no5tyle/pinewood-time/hardware/gate/stl/led_lens.stl

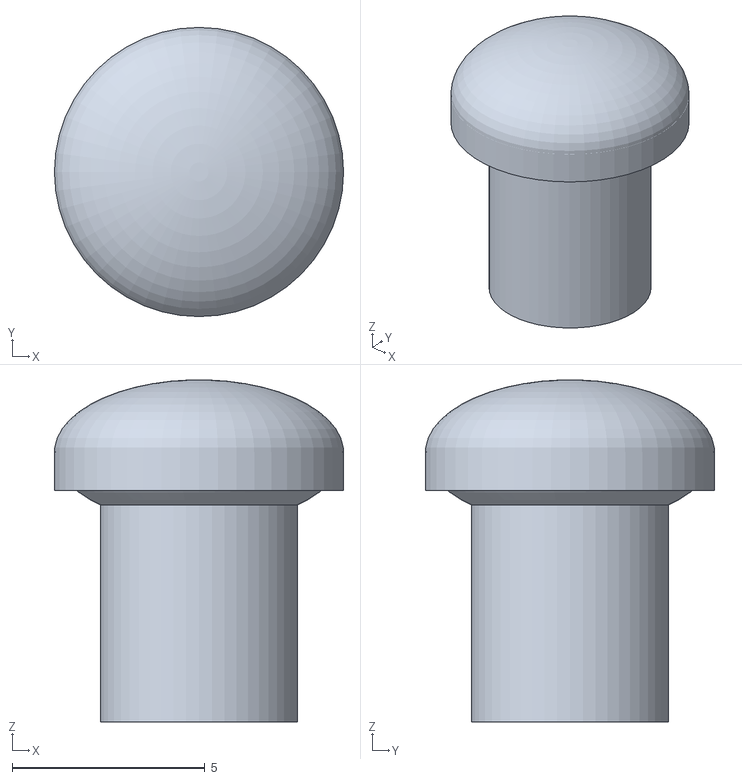
[picture p7: CAD file, 2026-11-12]
hardware/gate/stl/led_lens.stl
7.50 x 7.50 x 8.87
