no5tyle/pinewood-time/hardware/gate/stl/cover.stl

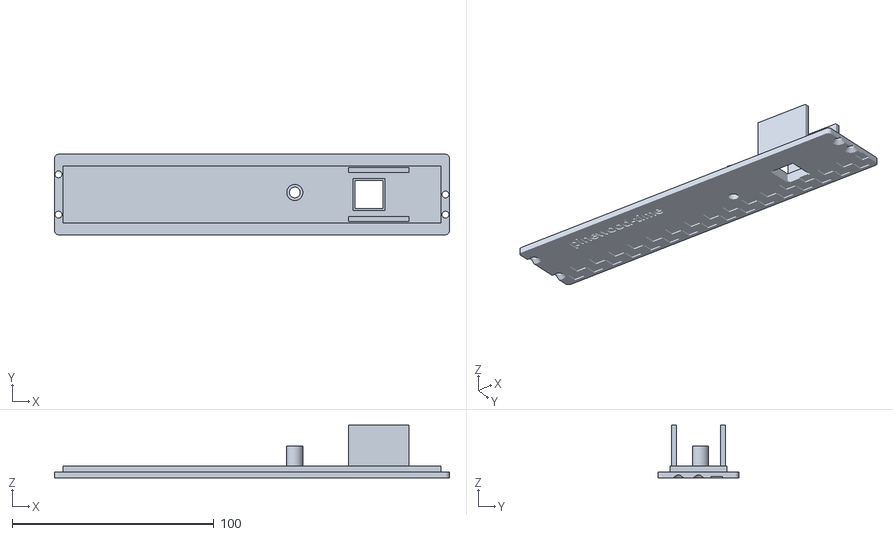
[picture p8: CAD file, 2026-11-12]
hardware/gate/stl/cover.stl
196.0 x 40.0 x 26.2
