no5tyle/pinewood-time/hardware/gate/stl/sensor_bar.stl

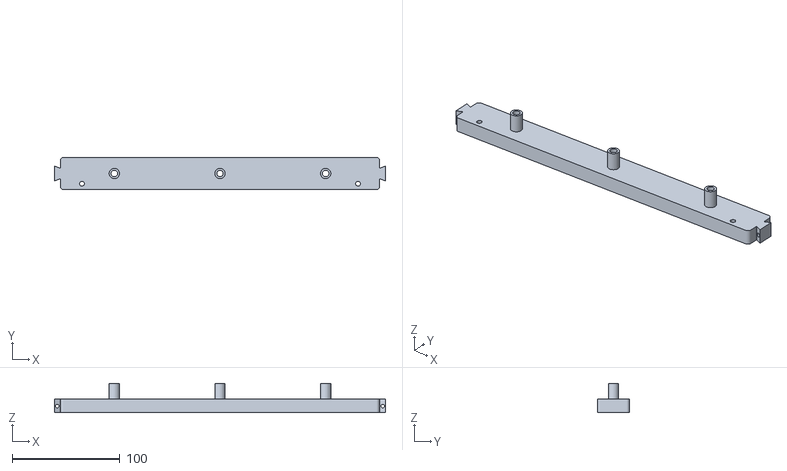
[picture p9: CAD file, 2026-11-12]
hardware/gate/stl/sensor_bar.stl
307.0 x 30.0 x 27.0
