no5tyle/pinewood-time/hardware/gate/stl/mx_blank.stl

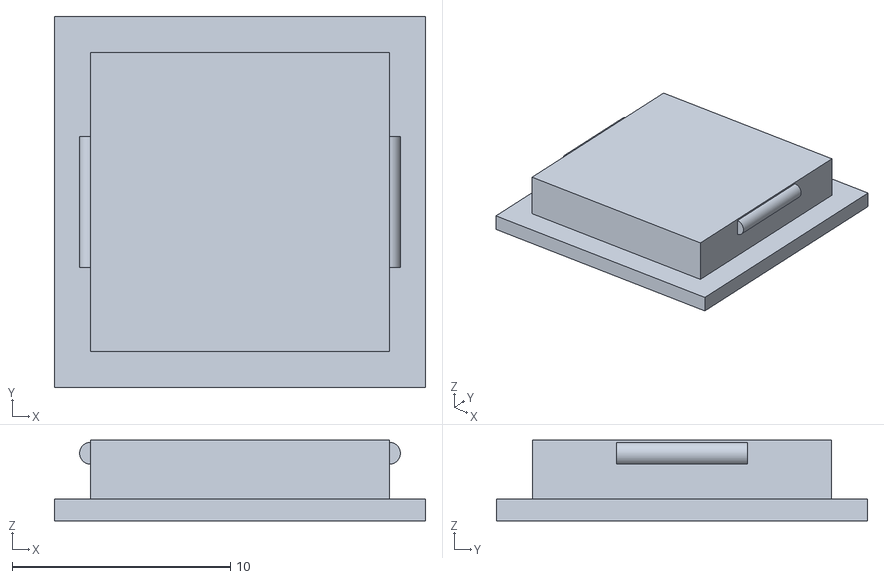
[picture p10: CAD file, 2026-11-12]
hardware/gate/stl/mx_blank.stl
17.0 x 17.0 x 3.70
