no5tyle/pinewood-time/hardware/gate/stl/right.stl

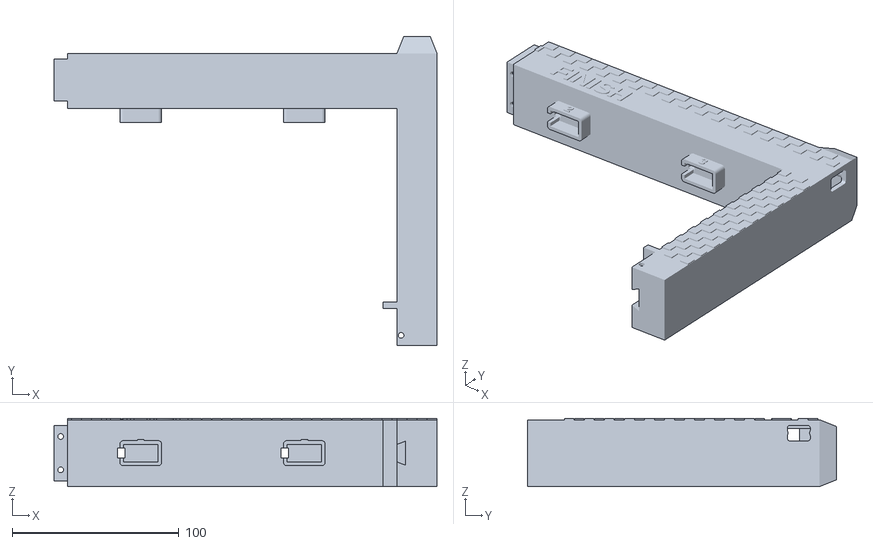
[picture p11: CAD file, 2026-11-12]
hardware/gate/stl/right.stl
229.5 x 185.0 x 40.8
