no5tyle/pinewood-time/hardware/gate/stl/left.stl

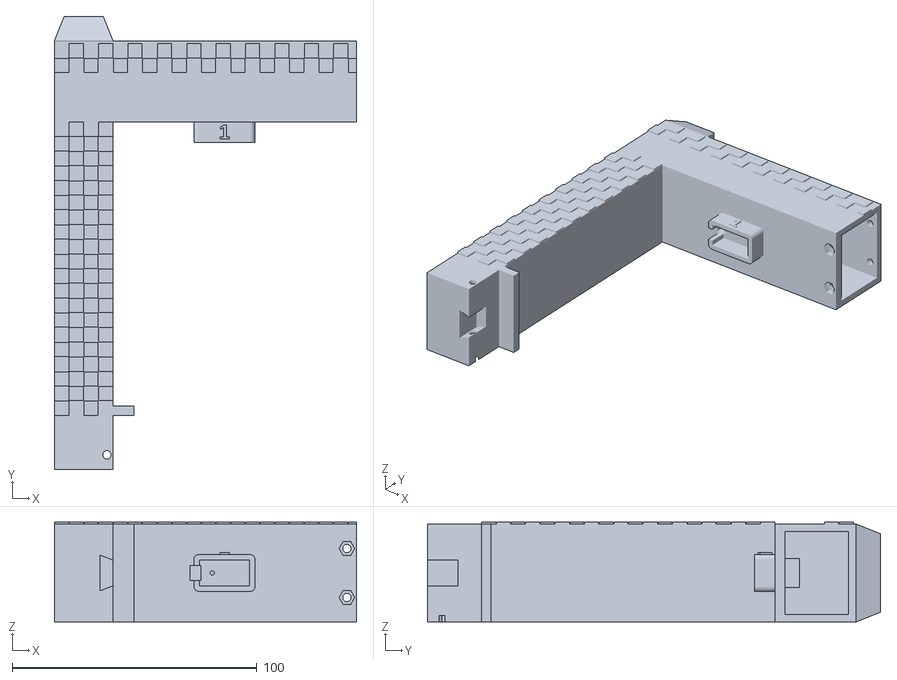
[picture p12: CAD file, 2026-11-12]
hardware/gate/stl/left.stl
123.5 x 185.0 x 40.8
