no5tyle/pinewood-time/docs/build-guide.pdf

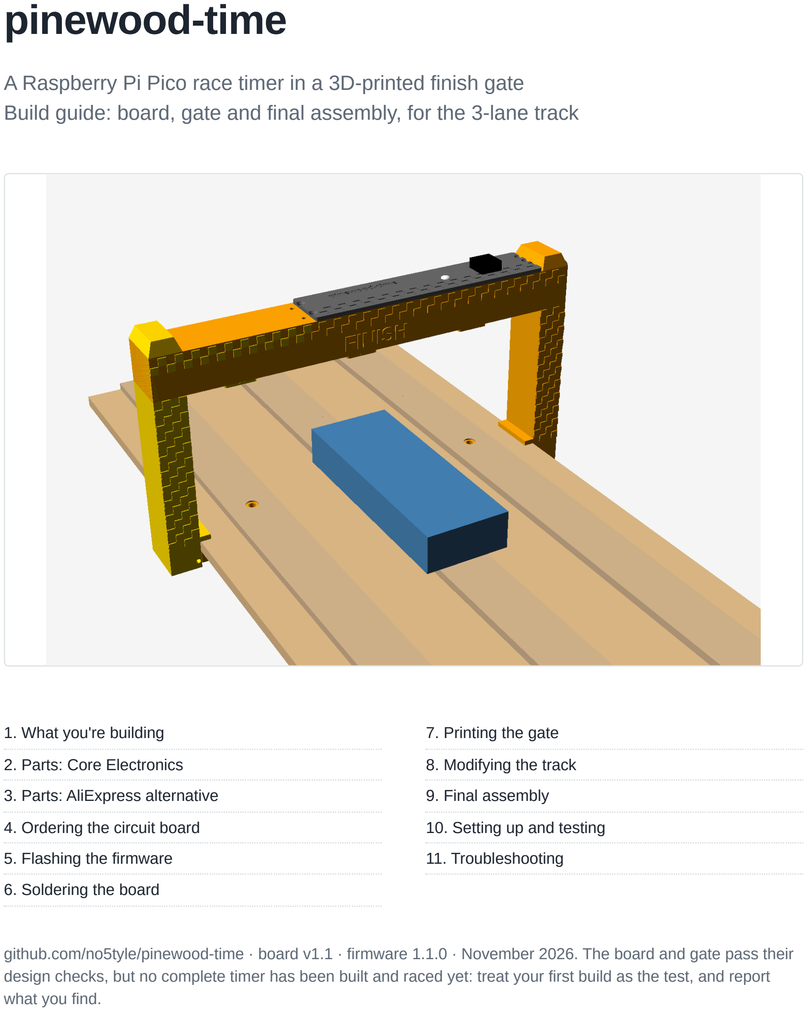
[picture p14: figure]
pinewood-time; 1. What you're building; 2. Parts: Core Electronics; 3. Parts: AliExpress alternative; 4. Ordering the circuit board; 5. Flashing the firmware; 6. Soldering the board; 7. Printing the gate; 8. Modifying the track; 9. Final assembly; 10. Setting up and testing; 11. Troubleshooting; what you find.

## A Raspberry Pi Pico race timer in a 3D-printed finish gate Build guide: board, gate and final assembly, for the 3-lane track

github.com/no5tyle/pinewood-time · board v1.1 · firmware 1.1.0 · November 2026. The board and gate pass their design checks, but no complete timer has been built and raced yet: treat your first build as the test, and report

pinewood-time build guide | 1 / 13

## 1. What you're building

A finish-line gantry that clamps onto the end of the track. A break-beam sensor watches each lane: an infrared emitter set into the rail shines up to a receiver in the gantry above, and a car crossing the line breaks the beam. The timer board inside the gantry's beam stamps each lane's crossing with the Pico's microsecond clock, counted from the moment the start gate drops, and sends the results to the race software over USB.

Timing: up to 8 lanes (this guide fits 3), results to 0.0001 s.
Race software: speaks the PDT timer's serial protocol, so software with a PDT option should drive it. Button: an MX keyboard switch on top resets the timer, or (with #button next ) calls up the next heat. Status light: amber blinking = waiting, green = ready, blue = racing, red = finished, white = test mode. Connection: one USB-C socket on the side of the gate; it's powered from the laptop.

The timer board, 178 × 28 mm. Lanes 1–8 on the left, then the gate, reset, display and spare connectors, the status light, and the Pico at the right-hand end.

Lane sensor input (x8, lane n 1..8
Jn: JST XH 4-pin, lane n to GP(n-1)

1 LED

2 SIG

3 GND

4 5V

Jn | Rn 180

5V

R10+n) 10k

3V3

R20+n) 1k
GP(n-1)

5V

A break-beam receiver or phototransistor switches SIG to GND as a car passes.

Start gate and reset
Switches to GND

1

2

J9 GATE

R31 10k

3V3

R32 1k
GP18

1

2

J10 RESET | R33 10k

3V3

R34 1k
GP19

Status light
D1 5 mm RGB, common cathode

GP20

R37 220

R

GP21

R38 220

G

GP22

R39 220

B

amber: waiting · green: ready · blue: racing · red: done

Lane displays I2C
J11 GND 3V3 SCL SDA
GP17 | SCL

R35 4.7k

3V3

GP16 | SDA

R36 4.7k

3V3
HT16K33 backpacks, address 0x70 lane 1

Power (from the Pico's USB
VBUS (pin 40 5V rail; 3V3 OUT (pin 36 3V3 rail

VBUS

5V rail

C1 100µF

3V3 OUT

3V3 rail

C2 100nF

J12 AUX GND, 3V3, 5V, GP26, GP27, GP28 for extras.

The circuit. Every input is pulled up to 3.3 V and reaches the Pico through a 1k resistor, so anything that switches to ground works.

### Tools

Soldering iron (a fine conical or 2 mm chisel tip), solder, side cutters
JST XH crimp tool (or solder the wires to pre-crimped leads), wire strippers
3D printer with a bed of at least 256 × 256 mm (the sensor bar lies diagonally)
Drill with a 10 mm bit and a small pilot bit, screwdrivers, M3 and M4 hex keys or spanners A computer with a serial terminal (the Arduino IDE's serial monitor, PuTTY, or screen )

## 2. Parts: Core Electronics

Everything for one 3-lane timer except the boards (JLCPCB, section 4) and the fasteners. Prices are rough, in Australian dollars with GST, from November 2026; check the listings before ordering.

Qty | Item | For | About
1 | Raspberry Pi Pico (or Pico H; solder it flat or on 2.5 mm headers) | U1 | $8–10
3 | Adafruit IR break-beam sensor, 3 mm LEDs (ADA2167) | one pair per lane | $6.20 each
1 | SparkFun resistor kit, 1/4 W, 500 pcs (COM-10969) | 5 × 10k, 5 × 1k, 3 × 220 Ω | $15
1 | DFRobot JST connector kit (FIT0255) | lane, gate and reset sockets, plugs, crimps | $14
1 | 100 µF radial electrolytic, 6.3 mm, 2.5 mm leg spacing (CE05258) | C1 | $1
1 | 100 nF ceramic disc, 5 mm leg spacing (CE05188) | C2 | $0.40
1 | SparkFun RGB LED, 5 mm, common cathode (COM- 09264) | D1, status light | $3.85
1 | 2.54 mm male header strip | J12 (1 × 6), and J11 if you fit displays | $1
1 | MX keyboard switch and a 1u keycap (any) | the button | $3
1 | Adafruit panel-mount USB-C to Micro-B cable, 30 cm (ADA4056) | USB-C socket on the gate | $10.60
1 | Lever microswitch | start gate | $2
1 | USB-C data cable (not charge-only) | gate to laptop | $8
~12 m 2-core cable (alarm or speaker wire) | start gate switch, about 10 m | $6

About A$100 for the parts, plus the boards and fasteners. The resistor and connector kits leave plenty for more boards.

### Fasteners (any hardware store, or an assortment kit)

Qty | Item | For
2 | M3 × 35 bolts and nuts | joining the two gate halves
2 | M3 × 40 bolts and nuts | lock pins through the legs and the sensor bar
4 | M3 × 12 countersunk self-tapping screws | the top cover
2 | M4 × 16 bolts and nuts | thumbscrews that clamp the gate to the track
2 | M2.5 × 6 self-tapping screws | the board's left end
6 | M2 × 10 self-tapping screws | one through each sensor's mounting hole

Not needed for 3 lanes: the 180 Ω resistors (R1–R8) only power bare IR LEDs, and the 4.7k resistors (R35, R36) and J11 are only for lane displays. The full 8-lane parts list is in hardware/fab/bom.md .

## 3. Parts: AliExpress alternative

Cheaper, slower (2–4 weeks), and you choose the seller, so check each listing's photos and dimensions. These are search terms rather than links, because listings come and go. The prices are typical figures for small packs, not quotes. Check them on the day.

Qty | Search for | Check | Typical
1 | "Raspberry Pi Pico RP2040" (official, from a store selling genuine boards) | Pico, or Pico 2 for the RP2350 build. Clones work if they're pin- compatible, but buy one marked Raspberry Pi if you can. | A$6–9
1 | "1/4W metal film resistor kit 600pcs" | Includes 10k, 1k, 220 Ω (and 4.7k). | A$3–5
1 | "XH2.54 connector kit 2P 3P 4P" with straight pin headers | Must say XH. KF2510 kits look alike but don't fit XH sockets. | A$4–7
1 | "electrolytic capacitor 100uF 16V 6.3x11" (or an assortment) | 6.3 mm diameter, 2.5 mm leg spacing. | A$2
1 | "ceramic capacitor 104 100nF 50V" (5 mm leg spacing) | Disc or multilayer, 5 mm pitch. | A$1–2
1 | "5mm RGB LED common cathode 4 pin" | Common cathode, legs in the order R, K, G, B (K the longest). | A$1–2
1 | "2.54mm single row male pin header 40P" | | A$1
1 | "MX switch" (Gateron, Outemu, Kailh) and "1u keycap" | 3-pin or 5-pin MX switch; plate-mount clips are what hold it in the cover. | A$3–6
1 | "panel mount USB type C female to micro USB male screw" | Must match the Adafruit one: 28 × 8.5 mm flange, M3 screws 20 mm apart, body 13 mm thick, about 40 mm long. Or adjust usb_cut in the model. | A$3–6
1 | "micro switch lever KW11" (or
similar)
Normally-closed contact (C and NC terminals). | A$1–2
1 | "M2 M3 M4 screw nut assortment
kit" (and M2.5 self-tappers)
See the fastener table on the previous page. | A$6–
10

Buy the sensors from Core Electronics (or Adafruit). The gate's pockets fit the Adafruit sensor's Omron housing exactly: 20 × 10 × 8 mm, LED on the broad face 5 mm from one end, 2.4 mm mounting hole 10 mm from the LED. Generic "IR break beam" pairs on AliExpress come in many housings and outputs. If you do buy them there, check the housing against those numbers, and that the receiver has an open-collector (NPN) output that goes low while it sees the beam.

A mixed order (sensors from Core, the rest from AliExpress) comes to roughly A$50–60 plus the boards.

## 4. Ordering the circuit board

The board is ordered as Gerber files: one zip, hardware/fab/pinewood-time-gerbers.zip , from the repository. JLCPCB is described here; PCBWay and others take the same zip.

1. Go to jlcpcb.com and choose Order now, then Add gerber file, and upload the zip. It reads the size itself: it should show 178 × 28 mm, 2 layers.
2. Settings: base material FR-4, 2 layers, quantity 5 (the minimum), thickness 1.6 mm, any colour, surface finish HASL (with lead or lead-free). Leave everything else at the default.
3. Check the preview: lane numbers 1–8 along one side, the Pico's outline at the right-hand end, and "pinewood-time v1.1" on the back.
4. Don't add assembly (it's all through-hole and quick to solder). Choose shipping and order.

Expect about US$5–10 for five boards plus shipping, arriving in one to two weeks.

The back of the board.

## 5. Flashing the firmware

Do this before soldering the Pico in, so you know it works.

1. Download dist/pinewood-time-pico.uf2 from the repository (or pinewood-time-pico2.uf2 for a Pico 2).
2. Hold the Pico's BOOTSEL button while plugging it into the computer. It appears as a drive called RPI-RP2 (RP2350 for a Pico 2).
3. Copy the .uf2 file onto it. The drive disappears and the Pico restarts as the timer.
4. Open the new serial port in a terminal (COMn on Windows, /dev/ttyACM0 on Linux, /dev/cu.usbmodem… on a Mac; any baud rate). Send I : it replies with its version and settings.

To update it later, either repeat this, or open the port at 1200 baud, which restarts the Pico ready for new firmware.

## 6. Soldering the board

For 3 lanes, fit these and leave the rest empty. Empty places do no harm, and can be filled later for more lanes.

Fit | Value
R11, R12, R13 | 10k (lane pull-ups)
R21, R22, R23 | 1k (lane series)
R31, R33 | 10k (gate, reset)
R32, R34 | 1k (gate, reset)
R37, R38, R39 | 220 Ω (status light)
C1, C2 | 100 µF, 100 nF
D1 | RGB LED
J1, J2, J3 | 4-pin JST XH (lanes 1–3)
J9, J10 | 2-pin JST XH (gate, reset)
J12 | 1 × 6 header (emitter power)
U1 | Pico
Leave empty | Why
R1–R8 | only for bare IR LEDs
R14–R18, R24–R28, J4–J8 | lanes 4–8
R35, R36, J11 | lane displays (optional)

### Order

1. C2 (100 nF), at the top beside the Pico. Either way round.
2. Resistors. They stand upright, three to a lane, with their values printed above them. Bend one lead down alongside the body, put the body into the hole inside the circle, solder, and trim. Either way round.
3. D1, the status light. Its longest leg (the common cathode, K) goes in the second hole from the left. Solder it with its base about 1 mm off the board.
4. C1, 100 µF: the long leg (+) to the square pad.
5. J12 header, and the JST sockets, turned to match their outlines.
6. The Pico, last, at the right-hand end with its USB socket just past the end of the board. In the gate there's 20 mm above the board, so solder it flat on its castellated edges, or on short (2.5 mm) headers, not tall sockets.

Check: plug it in. The status light should blink amber. Send #lanes 3 then #save .

## 7. Printing the gate

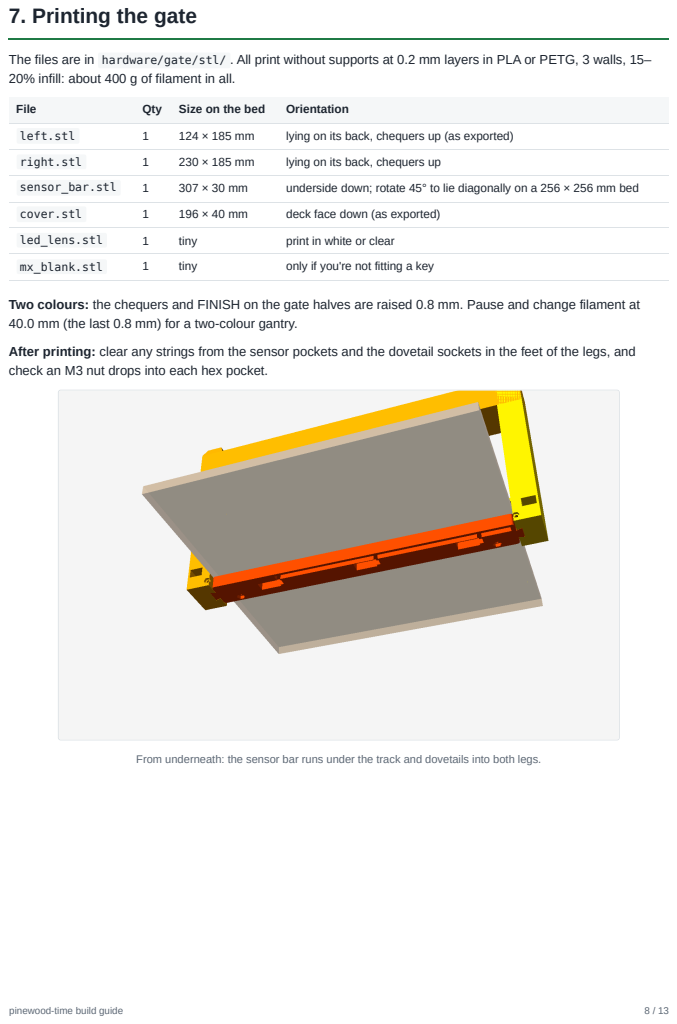
[picture p15: page 8]
File; Qty; Size on the bed; Orientation; left.stl; lying on its back, chequers up (as exported); right.stl; lying on its back, chequers up; sensor_bar.stl; underside down; rotate 45° to lie diagonally on a 256 × 256 mm bed; cover.stl; deck face down (as exported); led_lens.stl; tiny; print in white or clear; mx_blank.stl; only if you're not fitting a key

The files are in hardware/gate/stl/ . All print without supports at 0.2 mm layers in PLA or PETG, 3 walls, 15–
20% infill: about 400 g of filament in all.

Two colours: the chequers and FINISH on the gate halves are raised 0.8 mm. Pause and change filament at
40.0 mm (the last 0.8 mm) for a two-colour gantry.

After printing: clear any strings from the sensor pockets and the dovetail sockets in the feet of the legs, and
check an M3 nut drops into each hex pocket.

From underneath: the sensor bar runs under the track and dovetails into both legs.

## 8. Modifying the track

On Track E, the last section. The holes are the only change; nothing is screwed to the track, so the gate lifts off for packing.

1. Mark the finish line square across the board, 200 mm from the tail end. That keeps it clear of the tail support (42–84 mm from the end) and its screws.
2. Where the line crosses each rail centre line, 50, 148 and 246 mm from the left edge, drill a 10 mm hole through the rail and the board. Drill a pilot right through, then the 10 mm bit a few millimetres in from the underside, then finish from the top, so neither face splinters.

That leaves 15 mm of rail either side of each hole, so the rail still guides the wheels. The sensor bar's turrets come up into the holes and stop 1 mm below the rail top.

beam up to the receiver in the gantry, 120 mm above

cable, to the groove

M2 screw

9 board

6 rail

19 to the floor

13 bar

6 clear

8 sensor

turret top 1 mm below the rail top

Lane 2 at the finish line, cut across the track (mm, to scale)

One 10 mm hole through rail and board; the sensor bar (orange) holds the emitter flat underneath, looking up through its turret.

track board

rail | rail

floor

A cut across lane 2 at the finish line, to scale: the emitter lies flat in the sensor bar under the board and looks up through its turret.

The track has no stopping area after the finish. Plan something to catch the cars: a towel, or a padded board across the end.

## 9. Final assembly

### Gantry

1. Press M3 nuts into the hex pockets: two under the beam at the joint, and one at the back of each leg's foot. Press the two M4 nuts into the pockets under the ends of the sensor bar.
2. Slide the right half's tongue into the left half's beam, and bolt them together with the two M3 × 35 bolts down through the joint.
3. Receivers (the halves with three wires): feed each one's cable up through its pod's end into the beam, press it into the pod LED down, and screw it in with an M2 × 10 through its mounting hole.
4. Crimp each receiver to a 4-pin JST XH plug for its lane: red to pin 4 (5V), black to pin 3 (GND), white to pin 2 (SIG), pin 1 empty.
5. USB-C socket: push its Micro-B end in through the hole in the right leg from outside, and screw the flange on with its two M3 screws.
6. MX key: solder two wires to the switch's pins and crimp a 2-pin JST XH plug on the other end for RESET (J10). Clip the switch into the cover from the top, keycap on. (Or clip in the blank.)
7. Gate switch: run the 2-core cable from the start gate along the underside of the track, up the left leg (in at the slot at the back), along the beam, and crimp a 2-pin plug for GATE (J9). Wire it to the switch's C and NC terminals, so it's closed while the gate is up.

### Board

8. Lower the board onto its ledges in the right half of the beam, Pico to the right. Plug the Micro-B into the Pico and push the spare USB lead down the right leg's channel.
9. Plug in the three lane plugs (lane 1 to J1, and so on), GATE and RESET. Screw the board's left end down with the two M2.5 screws.
10. Push the lens into the cover and screw the cover on with four M3 × 12 screws. Its ribs hold the Pico's end of the board.

The board on its ledges inside the beam (front wall cut away), with the cover above and the USB plug heading into the right leg.

### Sensor bar

11. Emitters (the halves with two wires): screw each into its pocket under the bar, LED up, with an M2 × 10.

12. Join the three emitters' wires in the groove (reds together, blacks together) into one 2-core lead out of the bar's left end. Tape over the groove. Fit an inline 2-pin plug where the lead leaves the bar.
13. Make the matching lead for the board's AUX header (J12): GND on pin 1, 5V on pin 3, using a 3-way 2.54 mm housing over pins 1–3 with the middle empty. Run it down the left leg and out of the slot at its back.

### On the track

14. Set the gate on the board at the finish line, legs either side, top jaws on the board.
15. From underneath, push the sensor bar up so its turrets go into the three holes and its ends slide up into the legs' sockets, until it stops.
16. Push the two M3 × 40 lock pins through the legs and the bar, and fit their nuts. Tighten the M4 thumbscrews up against the board until snug.
17. Plug in the sensor bar's lead, and connect the gate's USB-C socket to the laptop.

The USB-C socket on the right leg.

## 10. Setting up and testing

### Settings

In a serial terminal (send each line followed by Enter):

#lanes 3

#save

Other settings, all saved with #save :

Send | Does
#gate-trip low | if your gate switch works the other way round (races start when you lift the gate)

#lane-trip low | if your sensors go high while they see the beam

#button next | the key calls up the next heat (sends #next and types Enter) instead of resetting

#button-key pagedown | the key that #button next types (enter, space, pagedown, f5, a letter...)

I | shows the version and all settings

### Test mode

1. Hold the MX key while plugging the timer in. The status light goes white.
2. The terminal shows test lanes=... gate=closed four times a second. Block each lane's beam with a hand or a car: its position should change to 1 . Open the start gate: gate=open .
3. Press the key to leave test mode.

### A test race

1. Close the gate and press the key: the light goes green (ready).
2. Drop the gate and run a car down each lane. The light goes blue while racing; the terminal shows B , then a line per lane, like 1 - 2.8734 , and the light goes red.
3. In the race software, choose the PDT timer, the gate's serial port, and 3 lanes.

Timing check: Adafruit gives the receivers' response time as under 2 ms. Before relying on close finishes, run the same car down each lane several times, and swap sensors between lanes, to see how consistent the lanes are. Until then, treat finishes within a couple of thousandths as ties.

## 11. Troubleshooting

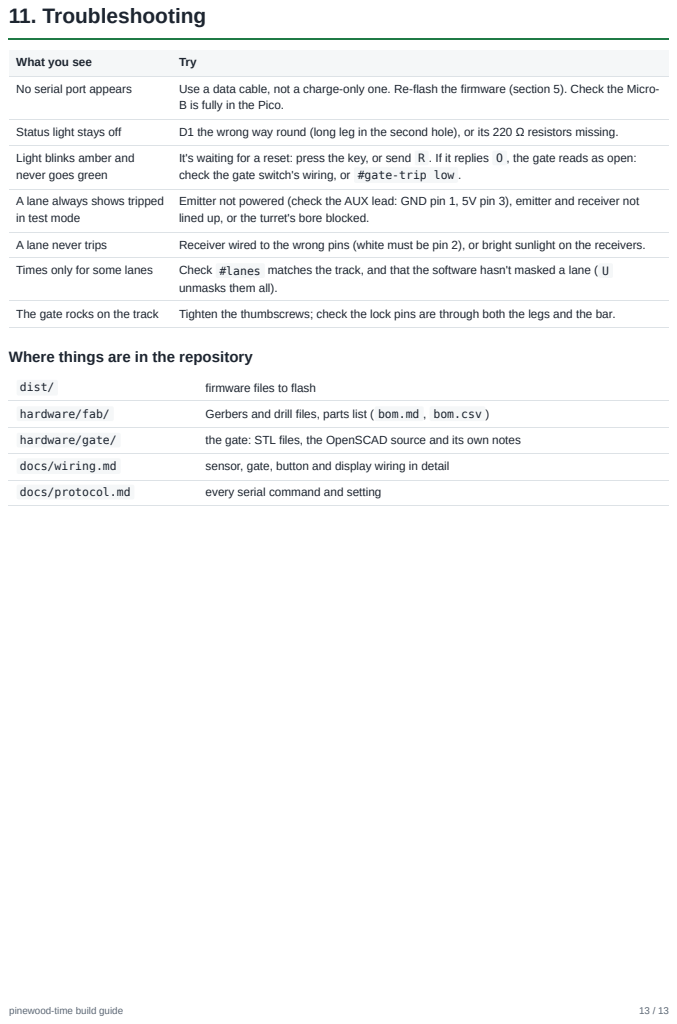
[picture p16: page 13]
What you see; Try; No serial port appears; Use a data cable, not a charge-only one. Re-flash the firmware (section 5). Check the Micro-; Status light stays off; D1 the wrong way round (long leg in the second hole), or its 220 Ω resistors missing.; A lane never trips; Receiver wired to the wrong pins (white must be pin 2), or bright sunlight on the receivers.; Times only for some lanes; Check #lanes matches the track, and that the software hasn't masked a lane ( U; The gate rocks on the track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

B is fully in the Pico.

Light blinks amber and
never goes green

It's waiting for a reset: press the key, or send R . If it replies O , the gate reads as open:
check the gate switch's wiring, or #gate-trip low .

A lane always shows tripped
in test mode

Emitter not powered (check the AUX lead: GND pin 1, 5V pin 3), emitter and receiver not
lined up, or the turret's bore blocked.

unmasks them all).

Where things are in the repository
