no5tyle/pinewood-time/hardware/pinewood-time.kicad_pcb

## KiCad design hardware/pinewood-time.kicad_pcb (2026-11-12)

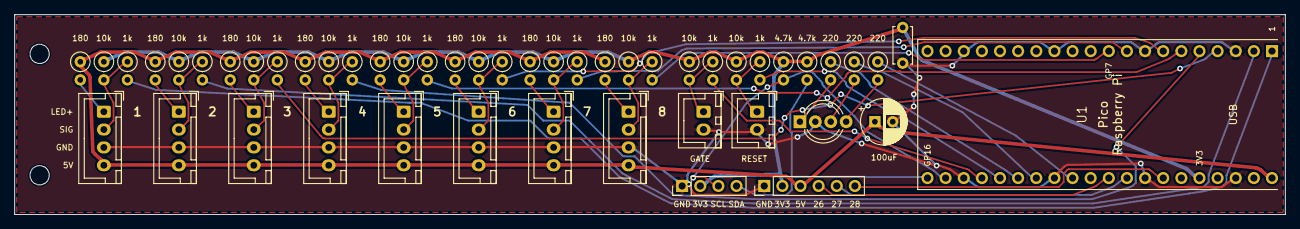
[picture p17: board pinewood-time.kicad_pcb from above]

Board: 2 copper layers, 178.0 x 28.0 mm, 51 parts (0 on the bottom side), 42 nets.

Parts:
C1: 100uF 10V; CP_Radial_D6.3mm_P2.50mm
C2: 100nF; C_Disc_D5.0mm_W2.5mm_P5.00mm
D1: RGB; LED_D5.0mm-4_RGB_Wide_Pins
H1, H2: M2.5; MountingHole_2.7mm_M2.5
J1: LANE 1; JST_XH_B4B-XH-A_1x04_P2.50mm_Vertical
J2: LANE 2; JST_XH_B4B-XH-A_1x04_P2.50mm_Vertical
J3: LANE 3; JST_XH_B4B-XH-A_1x04_P2.50mm_Vertical
J4: LANE 4; JST_XH_B4B-XH-A_1x04_P2.50mm_Vertical
J5: LANE 5; JST_XH_B4B-XH-A_1x04_P2.50mm_Vertical
J6: LANE 6; JST_XH_B4B-XH-A_1x04_P2.50mm_Vertical
J7: LANE 7; JST_XH_B4B-XH-A_1x04_P2.50mm_Vertical
J8: LANE 8; JST_XH_B4B-XH-A_1x04_P2.50mm_Vertical
J9: GATE; JST_XH_B2B-XH-A_1x02_P2.50mm_Vertical
J10: RESET; JST_XH_B2B-XH-A_1x02_P2.50mm_Vertical
J11: DISPLAYS; PinHeader_1x04_P2.54mm_Vertical
J12: AUX; PinHeader_1x06_P2.54mm_Vertical
R1, R2, R3, R4, R5, R6, R7, R8: 180; R_Axial_DIN0207_L6.3mm_D2.5mm_P2.54mm_Vertical
R11, R12, R13, R14, R15, R16, R17, R18, R31, R33: 10k; R_Axial_DIN0207_L6.3mm_D2.5mm_P2.54mm_Vertical
R21, R22, R23, R24, R25, R26, R27, R28, R32, R34: 1k; R_Axial_DIN0207_L6.3mm_D2.5mm_P2.54mm_Vertical
R35, R36: 4.7k; R_Axial_DIN0207_L6.3mm_D2.5mm_P2.54mm_Vertical
R37, R38, R39: 220; R_Axial_DIN0207_L6.3mm_D2.5mm_P2.54mm_Vertical
U1: Raspberry Pi Pico; RaspberryPi_Pico

Connections:
+3V3: C2.1, J11.2, J12.2, R11.1, R12.1, R13.1, R14.1, R15.1, R16.1, R17.1, R18.1, R31.1, R33.1, R35.1, R36.1, U1.36
AUX1: J12.4, U1.31
AUX2: J12.5, U1.32
AUX3: J12.6, U1.34
GATE: J9.1, R31.2, R32.1
GATE_IN: R32.2, U1.24
GND: C1.2, C2.2, D1.2, J1.3, J2.3, J3.3, J4.3, J5.3, J6.3, J7.3, J8.3, J9.2, J10.2, J11.1, J12.1, U1.3, U1.8, U1.13, U1.18, U1.23, U1.28, U1.33, U1.38
LANE1: R21.2, U1.1
LANE2: R22.2, U1.2
LANE3: R23.2, U1.4
LANE4: R24.2, U1.5
LANE5: R25.2, U1.6
LANE6: R26.2, U1.7
LANE7: R27.2, U1.9
LANE8: R28.2, U1.10
LED1: J1.1, R1.2
LED2: J2.1, R2.2
LED3: J3.1, R3.2
LED4: J4.1, R4.2
LED5: J5.1, R5.2
LED6: J6.1, R6.2
LED7: J7.1, R7.2
LED8: J8.1, R8.2
LED_B: D1.4, R39.2
LED_B_IN: R39.1, U1.29
LED_G: D1.3, R38.2
LED_G_IN: R38.1, U1.27
LED_R: D1.1, R37.2
LED_R_IN: R37.1, U1.26
RESET: J10.1, R33.2, R34.1
RESET_IN: R34.2, U1.25
SCL: J11.3, R35.2, U1.22
SDA: J11.4, R36.2, U1.21
SENSE1: J1.2, R11.2, R21.1
SENSE2: J2.2, R12.2, R22.1
SENSE3: J3.2, R13.2, R23.1
SENSE4: J4.2, R14.2, R24.1
SENSE5: J5.2, R15.2, R25.1
SENSE6: J6.2, R16.2, R26.1
SENSE7: J7.2, R17.2, R27.1
SENSE8: J8.2, R18.2, R28.1
VBUS: C1.1, J1.4, J2.4, J3.4, J4.4, J5.4, J6.4, J7.4, J8.4, J12.3, R1.1, R2.1, R3.1, R4.1, R5.1, R6.1, R7.1, R8.1, U1.40
