no5tyle/pinewood-time/(commit log)

2026-11-12 Pico race timer: carrier board, firmware and docs
    - Firmware (Pico SDK, Pico and Pico 2): PDT-compatible serial protocol over USB, up to 8 lanes timed in
    the GPIO interrupt, start gate and reset inputs, RGB status light, HT16K33 lane displays, settings in
    flash, sensor test mode. Host tests for the timer core.
    - Board (KiCad 7, generated by script): 112 x 82 mm, 2 layers, all through-hole. Routed by its own grid
    router, ground pours on both layers, DRC clean. Gerbers, drill files, BOM, schematic and renders.
    - Docs: build and assembly, track wiring, protocol. CI builds the firmware and runs the tests.
    Claude-Session: https://clau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
    [bom.csv, pinewood-time.kicad_pcb]
2026-11-12 Add a 3-lane kit guide
    Shopping list from Core Electronics, which parts to fit, sensor and gate wiring, setup, and the lane
    display add-on.
    Claude-Session: https://claude.ai/code/session_01EZKejL16snRsfncvny1AF8
2026-11-12 Reset button can ask the race software for the next heat
    "#button next" makes the reset button send "#next" on the serial port and type a key (set with
    "#button-key", default Enter) on a USB keyboard the timer now also presents. During a race it still ends
    the race, and with no software listening it falls back to a reset. "#button reset" (the default) keeps
    the old behaviour.
    USB is now run directly with TinyUSB (serial port + keyboard) instead of the SDK's stdio serial port; it
    keeps the 1200 baud restart into the bootloader. Settings layout bumped (PTM2), so saved settings reset
    to the defaults once. Firmware 1.1.0.
    Claude-Session: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
    [main.c, settings.c, timer_core.c, timer_core.h, tusb_config.h, usb.c, usb.h]
2026-11-12 Add a 3D-printed finish gate for the 3-lane track
    A finish-line gantry (OpenSCAD, parametric) sized from the Pinewood Derby Track Build guide: clamps onto
    the board edges, holds a break-beam receiver over each lane, and houses the timer board in a pod with an
    MX switch socket (or a blank plug) and a status light window. Printed holders set the emitters into the
    rails at the finish line, inside the 19 mm under the board. STLs, renders, a to-scale fit drawing, and a
    guide for modifying the track.
    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
    [finish-gate.scad, led_lens.stl, left.stl, lid.stl, mx_blank.stl, pod.stl, right.stl, track_holder.stl]
2026-11-12 Finish gate: one sensor bar under the track, dovetailed into the legs
    The three separate track holders become a single printed bar under the board at the finish line. Its
    turrets rise into the rail slots and hold the emitters; a channel inside takes their wiring to one 2-core
    lead (for the AUX header's 5V and GND). Each end is a dovetail that slides up into a socket in the leg,
    locked by an M3 pin, and an M4 thumbscrew in each end clamps the board against the legs' top jaws, so
    nothing is screwed to the track. Legs now stand 0.5 mm clear of the board edges. Checked for clashes
    between the bar and the gantry.
    Claude-Session: https://cla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
    [finish-gate.scad, led_lens.stl, left.stl, lid.stl, mx_blank.stl, pod.stl, right.stl, sensor_bar.stl]
2026-11-12 Finish gate: sensors lie flat, as the Adafruit housing really is
    The Adafruit 3 mm break-beam halves are Omron housings with the LED on the broad 20 x 10 face, 5 mm from
    one end, and a 2.4 mm mounting hole 10 mm from it. Both mounts now hold them flat by an M2 screw through
    that hole:
    - gantry: a small pod under the beam over each lane, receiver LED down, cable up into the beam
    - sensor bar: each emitter in a pocket underneath, LED up, looking through a 6 mm bore in a round turret;
    the wiring runs in a groove under the bar
    The track change becomes one 10 mm hole per lane through rail and board, instead of a filed slot.
    Claude-Sessio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
    [finish-gate.scad, led_lens.stl, left.stl, lid.stl, mx_blank.stl, pod.stl, right.stl, sensor_bar.stl]
2026-11-12 Long board that fits inside the finish gate's beam; drop the pod
    Board v1.1: 178 x 28 mm instead of 112 x 82, same circuit and all 8 lanes. The Pico lies along one end
    with its USB socket out past the board's end; each lane is a column of a socket and three upright
    resistors (values printed above them). The on-board reset button, C3 and two mounting holes are gone:
    the gate's MX key goes to J10. DRC clean, fully connected.
    Router: deterministic part order, rip-up-and-retry with the failed nets first, ground routed as tracks
    as well as poured, 0.1 mm grid, 0.25 mm signal tracks (0.2 mm clearance in the rules).
    Gate: no pod. The board lies inside the beam's right half on ledges under a remov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
    [bom.csv, cover.stl, finish-gate.scad, led_lens.stl, left.stl, lid.stl, mx_blank.stl, pinewood-time.kicad_pcb]
2026-11-12 Finish gate: USB-C panel socket on the right leg
    Fits Adafruit's panel-mount USB-C to Micro-B cable (ADA4056, from its drawing 4056_PCM-A-003): a rounded
    9.2 x 13.8 mm hole in the right leg's outer face at beam height, with bosses for the flange's two M3
    screws 20 mm apart. The socket's body runs inside the beam in front of the Pico's plug and clear of the
    board (checked for clashes); the right cover-screw block is notched round it and its screws moved.
    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
    [cover.stl, finish-gate.scad, led_lens.stl, left.stl, mx_blank.stl, right.stl, sensor_bar.stl]
2026-11-12 Add a printable build guide (PDF)
    docs/build-guide.pdf, from docs/build-guide/build-guide.html (node docs/build-guide/make-pdf.js): parts
    lists from Core Electronics and an AliExpress alternative (search terms and typical prices, with what to
    check), ordering the board from JLCPCB, flashing, soldering the 3-lane fit, printing the gate, the track
    change, final assembly, setup and test mode, and troubleshooting.
    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
2026-11-12 README: the finish gate and its assembly, with pictures
    The gate on the track as the opening picture, then the board and circuit, an exploded view of the gate
    naming each part (new render: part "exploded" in finish-gate.scad, made by build.sh), and an assembly
    step with the board in the beam, the sensor in the track, the sensor bar and the USB-C socket. Also fixes
    two stale lines (the board has no button of its own now; 49 parts) and mentions Pinewood Control's timer
    add-on.
    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
    [finish-gate.scad]
